stevehayles/HALMET-hardware/assembly/HALMET-In1_Cu.dxf

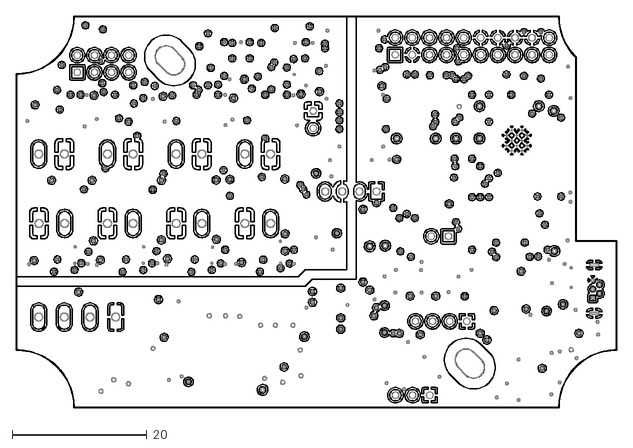
[picture p1: CAD file, 2025-12-01]
assembly/HALMET-In1_Cu.dxf
89.1 x 58.0
