stevehayles/HALMET-hardware/assembly/HALMET-B_Cu.dxf

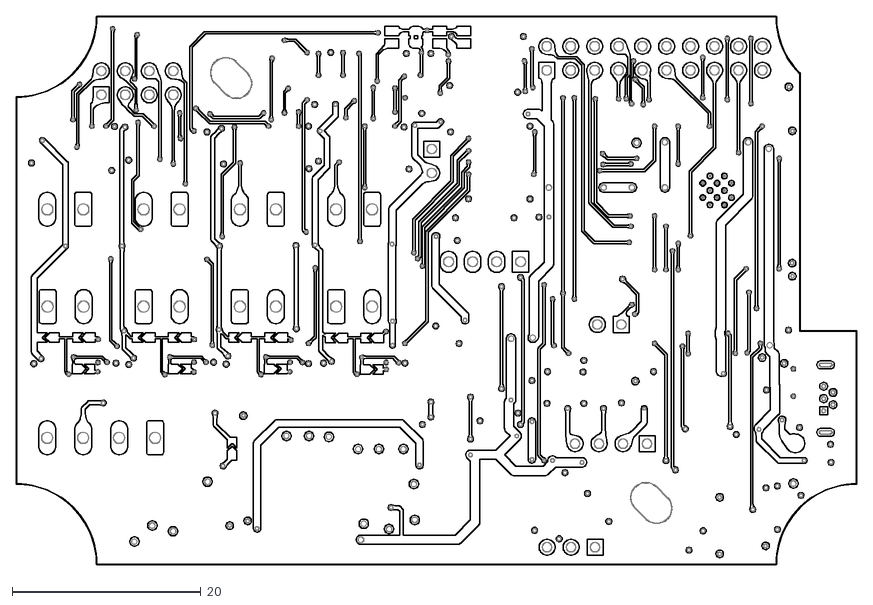
[picture p2: CAD file, 2025-12-01]
assembly/HALMET-B_Cu.dxf
89.1 x 58.0
