stevehayles/HALMET-hardware/assembly/HALMET-Edge_Cuts.dxf

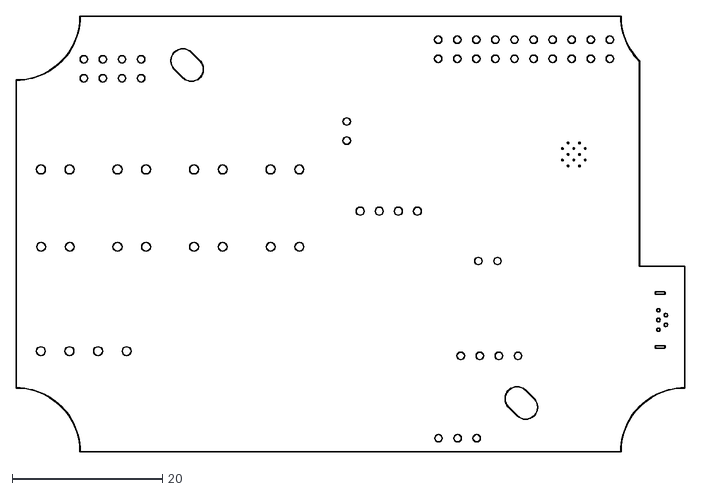
[picture p3: CAD file, 2025-12-01]
assembly/HALMET-Edge_Cuts.dxf
89.1 x 58.0
