stevehayles/HALMET-hardware/assembly/HALMET-F_Cu.dxf

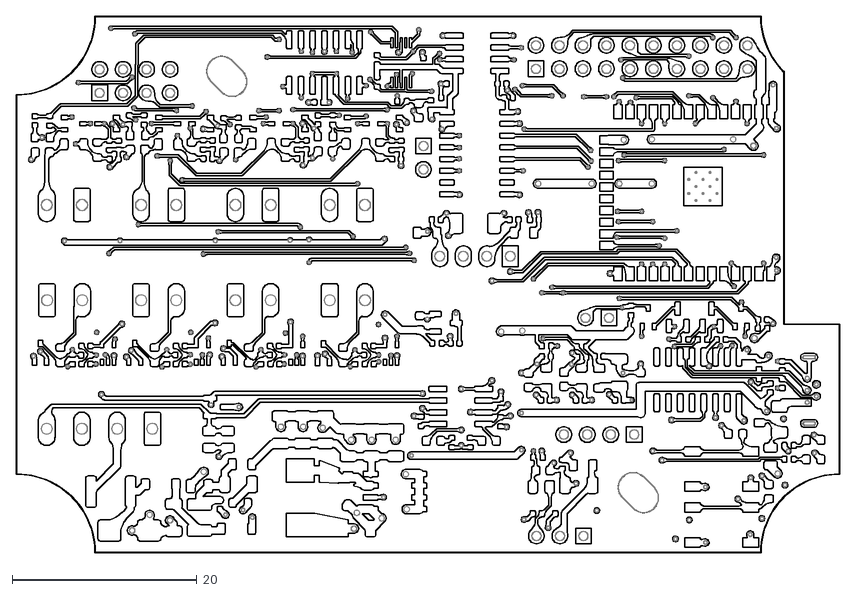
[picture p4: CAD file, 2025-12-01]
assembly/HALMET-F_Cu.dxf
89.1 x 58.0
