stevehayles/HALMET-hardware/(list of files, cad)

Other CAD files:
assembly/HALMET-B_Mask.dxf
assembly/HALMET-B_Silkscreen.dxf
assembly/HALMET-F_Mask.dxf
assembly/HALMET-F_Paste.dxf
assembly/HALMET-F_Silkscreen.dxf
