stevehayles/HALMET-hardware/HALMET.kicad_pcb

## KiCad design HALMET.kicad_pcb (2026-01-08)

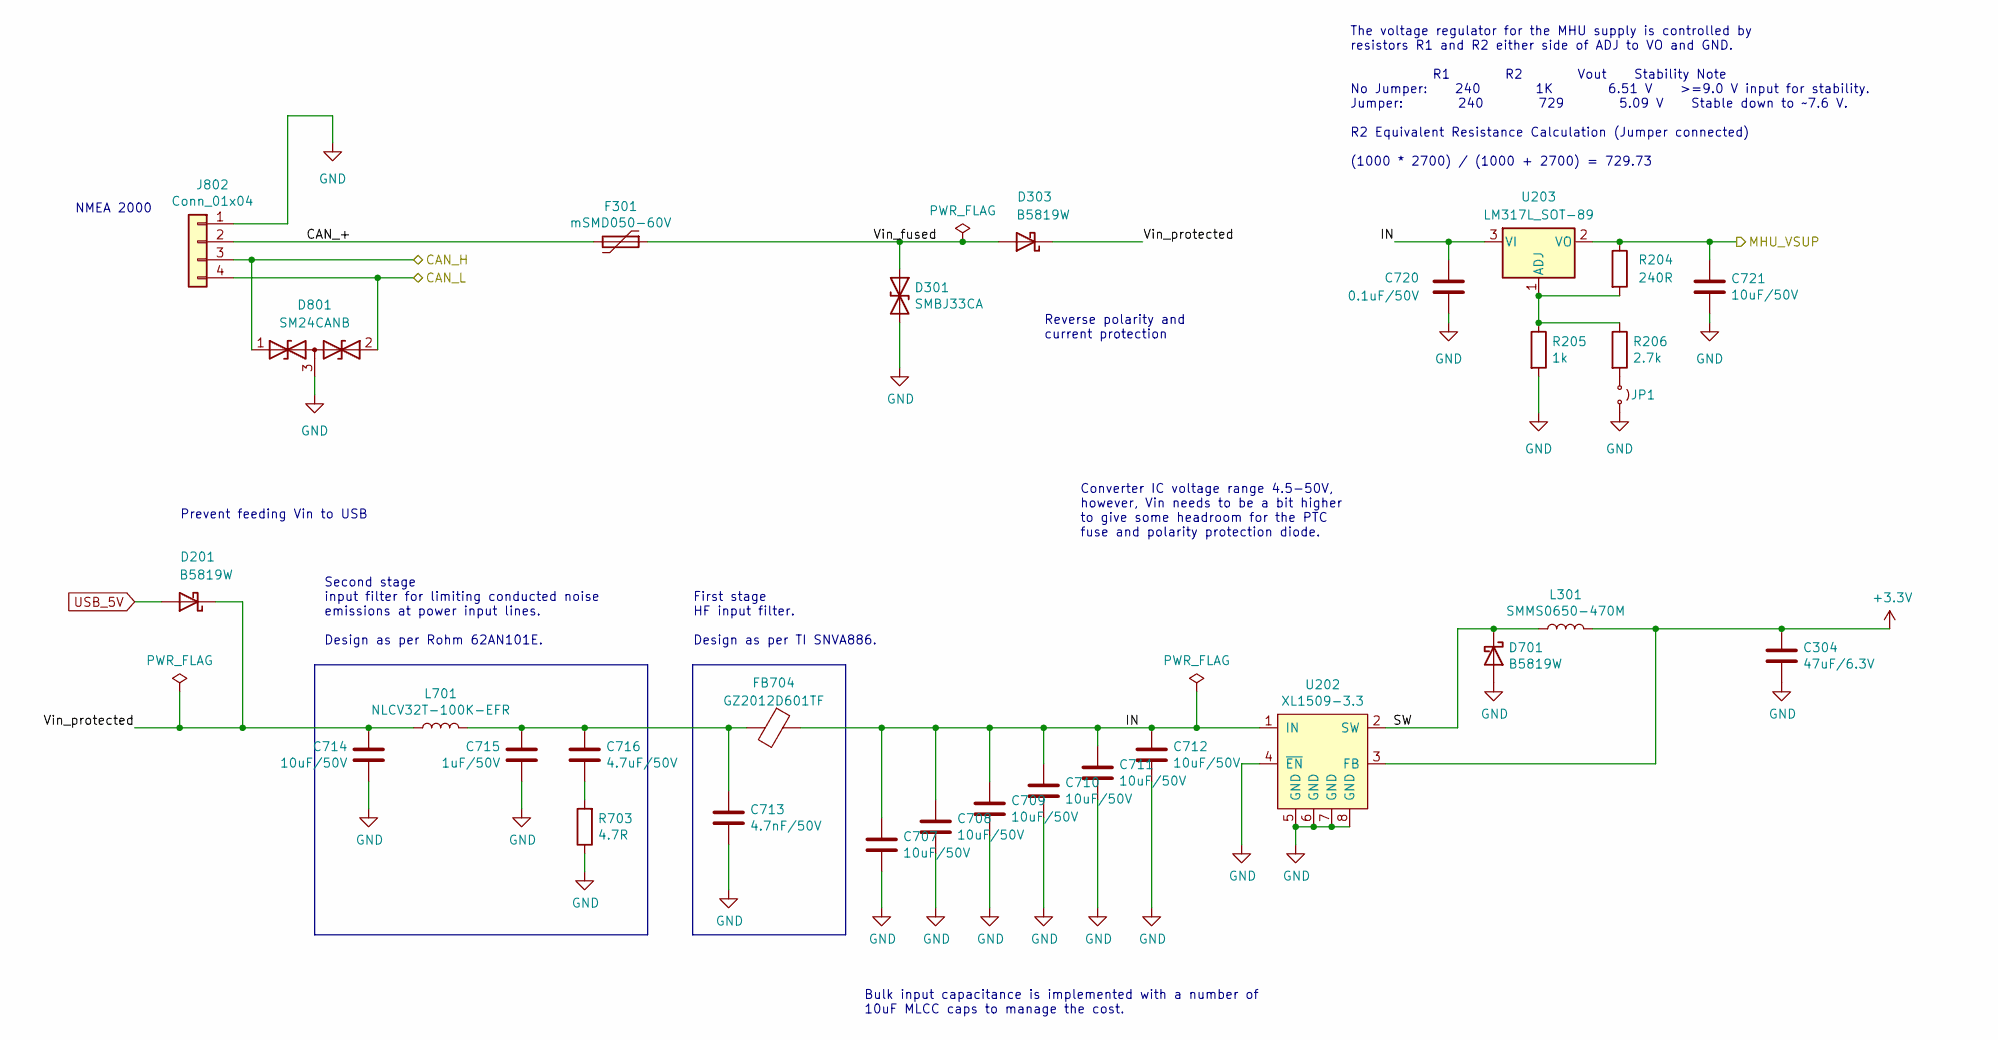
[picture p5: schematic power-input.kicad_sch, Bluefin Marine Processor]

Parts:
C304: 47uF/6.3V; C_1206_3216Metric; LCSC C96123
C707, C708, C709, C710, C711, C712, C714, C721: 10uF/50V; C_1206_3216Metric; LCSC C13585
C713: 4.7nF/50V; C_0402_1005Metric; LCSC C1538
C715: 1uF/50V; C_0805_2012Metric; LCSC C28323
C716: 4.7uF/50V; C_1206_3216Metric; LCSC C29823
C720: 0.1uF/50V; C_1206_3216Metric; LCSC C24497
D201, D303, D701: B5819W; D_SOD-123; LCSC C8598
D301: SMBJ33CA; D_SMB; LCSC C114000
D801: SM24CANB; SOT-23; LCSC C41376477
F301: mSMD050-60V; Fuse_1812_4532Metric; LCSC C70113
FB704: GZ2012D601TF; L_0805_2012Metric; LCSC C1017
J802: Conn_01x04; PhoenixContact_MCV_1,5_4-G-3.81_1x04_P3.81mm_Vertical; LCSC C8410
JP1: Jumper_2_Small_Open; PinHeader_1x02_P2.00mm_Vertical; LCSC C541856
L301: SMMS0650-470M; SMMS0650-1R0M; LCSC C149588
L701: NLCV32T-100K-EFR; L_1210_3225Metric; LCSC C295195
R204: 240R; R_0402_1005Metric; LCSC C25094
R205: 1k; R_0402_1005Metric; LCSC C11702
R206: 2.7k; R_0402_1005Metric; LCSC C25885
R703: 4.7R; R_0603_1608Metric; LCSC C23164
U202: XL1509-3.3; SOP-8_3.9x4.9mm_P1.27mm; LCSC C2681226
U203: LM317L_SOT-89; SOT-89-3; LCSC C5444280

Connections:
+3.3V: C304.1, L301.2, U202.3 (FB); also elsewhere on the board
/CAN_H: D801.1 (A1), J802.3; also elsewhere on the board
/CAN_L: D801.2 (A2), J802.4; also elsewhere on the board
/MHU_VSUP: C721.1, R204.1, U203.2 (VO); also elsewhere on the board
/Power input/CAN_+: F301.2, J802.2
/Power input/IN: C707.1, C708.1, C709.1, C710.1, C711.1, C712.1, C720.1, FB704.1, U202.1 (IN), U203.3 (VI)
/Power input/SW: D701.1 (K), L301.1, U202.2 (SW)
/Power input/Vin_fused: D301.1 (A1), D303.2 (A), F301.1
/Power input/Vin_protected: C714.2, D201.1 (K), D303.1 (K), L701.1
GND: C304.2, C707.2, C708.2, C709.2, C710.2, C711.2, C712.2, C713.2, C714.1, C715.1, C720.2, C721.2, D301.2 (A2), D701.2 (A), D801.3 (common), J802.1, JP1.2 (B), R205.2, R703.1, U202.4 (~EN), U202.5 (GND), U202.6 (GND), U202.7 (GND), U202.8 (GND); also elsewhere on the board
unnamed: C713.1, C715.2, C716.1, FB704.2, L701.2
unnamed: C716.2, R703.2
unnamed: JP1.1 (A), R206.2
unnamed: R204.2, R205.1, R206.1, U203.1 (ADJ)
USB_5V: D201.2 (A); also elsewhere on the board

Notes on the sheet:
Converter IC voltage range 4.5-50V, however, Vin needs to be a bit higher to give some headroom for the PTC fuse and polarity protection diode.
NMEA 2000
Bulk input capacitance is implemented with a number of 10uF MLCC caps to manage the cost.
Second stage input filter for limiting conducted noise emissions at power input lines. Design as per Rohm 62AN101E.
First stage HF input filter. Design as per TI SNVA886.
The voltage regulator for the MHU supply is controlled by resistors R1 and R2 either side of ADJ to VO and GND. R1 R2 Vout Stability Note No Jumper: 240 1K 6.51 V >=9.0 V input for stability. Jumper: 240 729 5.09 V Stable down to ~7.6 V. R2 Equivalent Resistance Calculation (Jumper connected) (1000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
Prevent feeding Vin to USB
Reverse polarity and current protection

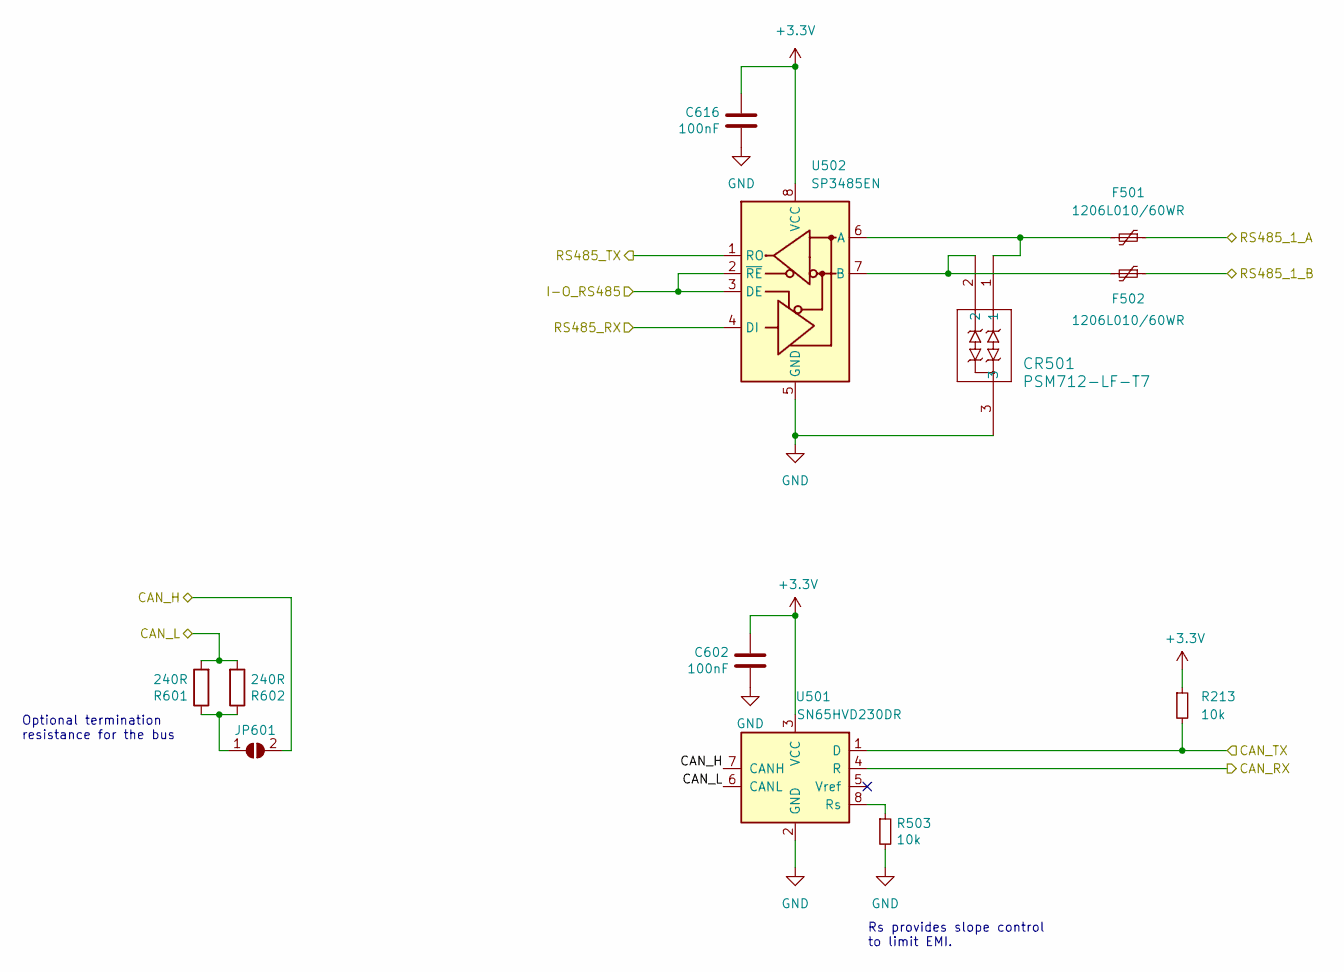
[picture p6: schematic serial.kicad_sch, Bluefin Marine Processor]

Parts:
C602, C616: 100nF; C_0402_1005Metric; LCSC C1525
CR501: PSM712-LF-T7; CR_SOT-23_PTD; LCSC C32677
F501, F502: 1206L010/60WR; 1206L075132WR; LCSC C2153714
JP601: SolderJumper_2_Open; SolderJumper-2_P1.3mm_Open_TrianglePad_Narrow
R213, R503: 10k; R_0402_1005Metric; LCSC C25744
R601, R602: 240R; R_0805_2012Metric; LCSC C17572
U501: SN65HVD230DR; SOIC-8_3.9x4.9mm_P1.27mm; LCSC C12084
U502: SP3485EN; SOIC-8_3.9x4.9mm_P1.27mm; LCSC C8963

Connections:
+3.3V: C602.1, C616.1, R213.1, U501.3 (VCC), U502.8 (VCC); also elsewhere on the board
/CAN_H: JP601.2 (B), U501.7 (CANH); also elsewhere on the board
/CAN_L: R601.2, R602.2, U501.6 (CANL); also elsewhere on the board
/CAN_RX: U501.4 (R); also elsewhere on the board
/CAN_TX: R213.2, U501.1 (D); also elsewhere on the board
/I-O_RS485: U502.2 (~RE), U502.3 (DE); also elsewhere on the board
/RS485_1_A: F501.1; also elsewhere on the board
/RS485_1_B: F502.1; also elsewhere on the board
/UART1_RX: U502.1 (RO); also elsewhere on the board
/UART1_TX: U502.4 (DI); also elsewhere on the board
GND: C602.2, C616.2, CR501.3, R503.2, U501.2 (GND), U502.5 (GND); also elsewhere on the board
unnamed: JP601.1 (A), R601.1, R602.1
unnamed: R503.1, U501.8 (Rs)
unnamed: CR501.1, F501.2, U502.6 (A)
unnamed: CR501.2, F502.2, U502.7 (B)

Notes on the sheet:
Rs provides slope control to limit EMI.
Optional termination resistance for the bus

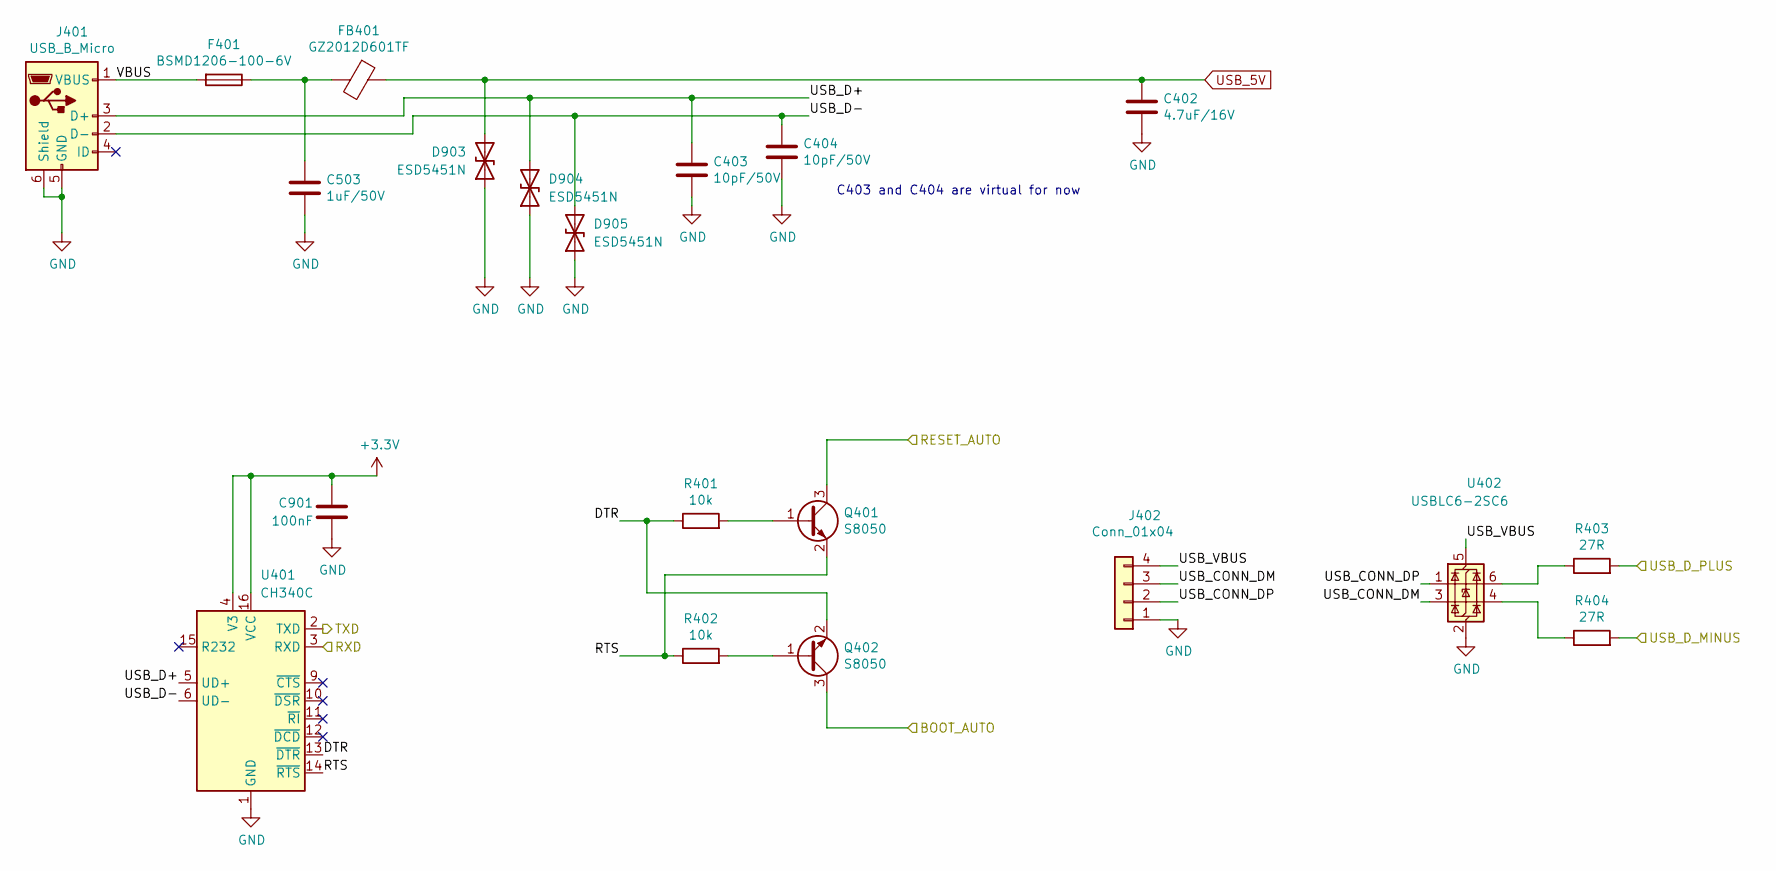
[picture p7: schematic USB.kicad_sch, Bluefin Marine Processor]

Parts:
C402: 4.7uF/16V; C_0603_1608Metric; LCSC C19666
C403, C404: 10pF/50V; C_0402_1005Metric; LCSC C32949
C503: 1uF/50V; C_0805_2012Metric; LCSC C28323
C901: 100nF; C_0402_1005Metric; LCSC C1525
D903, D904, D905: ESD5451N; D_0402_1005Metric; LCSC C2936977
F401: BSMD1206-100-6V; Fuse_1206_3216Metric; LCSC C883129
FB401: GZ2012D601TF; L_0805_2012Metric; LCSC C1017
J401: USB_B_Micro; USB_Micro-B_Wuerth_614105150721_Vertical; LCSC C145795
J402: Conn_01x04; JST_SH_BM04B-SRSS-TB_1x04-1MP_P1.00mm_Vertical; LCSC C160390
Q401, Q402: S8050; SOT-23; LCSC C2146
R401, R402: 10k; R_0402_1005Metric; LCSC C25744
R403, R404: 27R; R_0201_0603Metric; LCSC C270320
U401: CH340C; SOIC-16_3.9x9.9mm_P1.27mm; LCSC C84681
U402: USBLC6-2SC6; SOT-23-6; LCSC C7519

Connections:
+3.3V: C901.1, U401.4 (V3), U401.16 (VCC); also elsewhere on the board
/BOOT_AUTO: Q402.3 (C); also elsewhere on the board
/RESET_AUTO: Q401.3 (C); also elsewhere on the board
/UART0_RX: U401.2 (TXD); also elsewhere on the board
/UART0_TX: U401.3 (RXD); also elsewhere on the board
/USB/DTR: Q402.2 (E), R401.1, U401.13 (~DTR)
/USB/RTS: Q401.2 (E), R402.1, U401.14 (~RTS)
/USB/USB_CONN_DM: J402.3, U402.3 (I/O2)
/USB/USB_CONN_DP: J402.2, U402.1 (I/O1)
/USB/USB_D+: C403.1, D904.2 (A2), J401.3 (D+), U401.5 (UD+)
/USB/USB_D-: C404.1, D905.2 (A2), J401.2 (D-), U401.6 (UD-)
/USB/USB_VBUS: J402.4, U402.5 (VBUS)
/USB/VBUS: F401.2, J401.1 (VBUS)
/USB_D_MINUS: R404.2; also elsewhere on the board
/USB_D_PLUS: R403.2; also elsewhere on the board
GND: C402.2, C403.2, C404.2, C503.2, C901.2, D903.1 (A1), D904.1 (A1), D905.1 (A1), J401.5 (GND), J401.6 (Shield), J402.1, U401.1 (GND), U402.2 (GND); also elsewhere on the board
unnamed: C503.1, F401.1, FB401.2
unnamed: Q401.1 (B), R401.2
unnamed: Q402.1 (B), R402.2
unnamed: R403.1, U402.6 (I/O1)
unnamed: R404.1, U402.4 (I/O2)
USB_5V: C402.1, D903.2 (A2), FB401.1; also elsewhere on the board

Notes on the sheet:
C403 and C404 are virtual for now

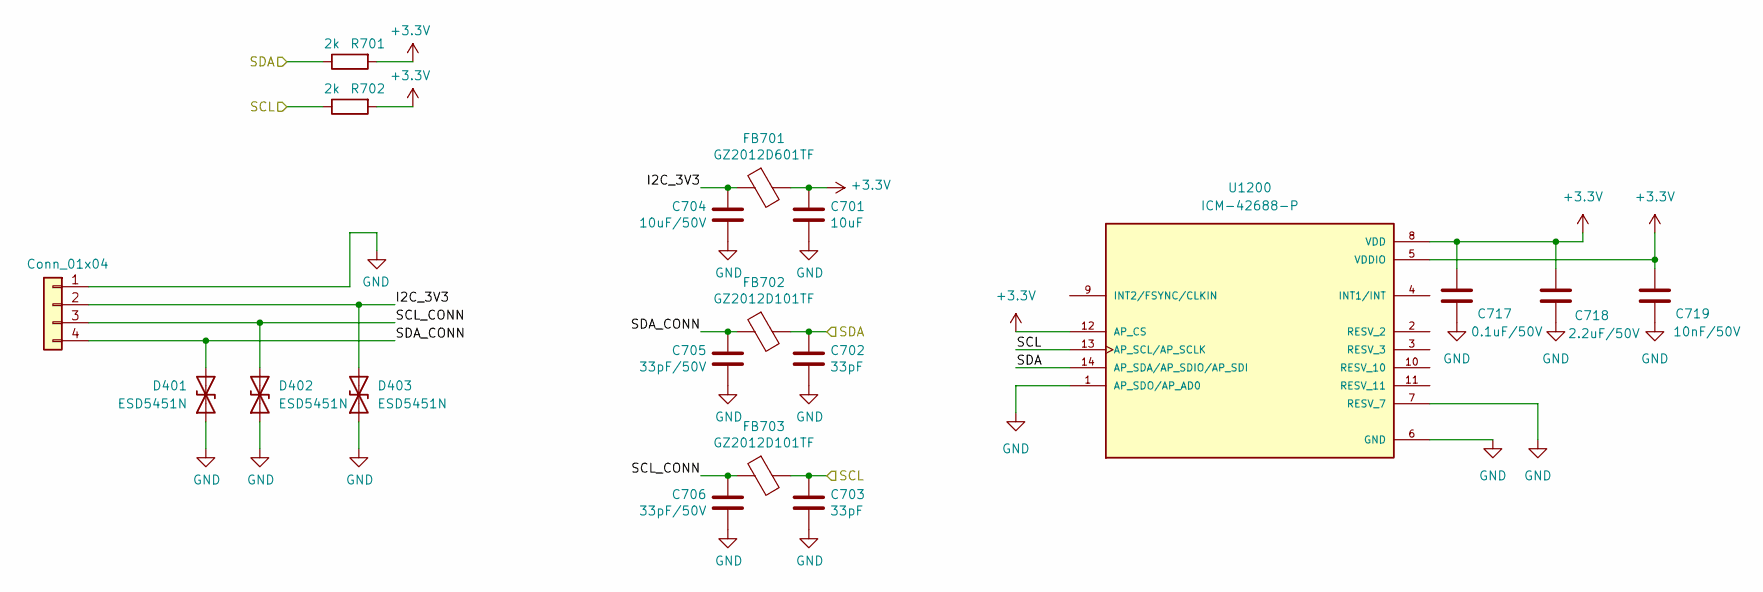
[picture p8: schematic I2C.kicad_sch, Bluefin Marine Processor]

Parts:
C701: 10uF; C_0402_1005Metric; LCSC C15525
C702, C703: 33pF; C_0402_1005Metric; LCSC C1562
C704: 10uF/50V; C_1206_3216Metric; LCSC C13585
C705, C706: 33pF/50V; C_0603_1608Metric; LCSC C1663
C717: 0.1uF/50V; C_1206_3216Metric; LCSC C24497
C718: 2.2uF/50V; C_1206_3216Metric; LCSC C50254
C719: 10nF/50V; C_1206_3216Metric; LCSC C153292
D401, D402, D403: ESD5451N; D_0402_1005Metric; LCSC C2936977
FB701: GZ2012D601TF; L_0805_2012Metric; LCSC C1017
FB702, FB703: GZ2012D101TF; L_0805_2012Metric; LCSC C1015
J702: Conn_01x04; PinSocket_1x04_P2.54mm_Vertical; LCSC C124413
R701, R702: 2k; R_0402_1005Metric; LCSC C4109
U1200: ICM-42688-P; PQFN50P300X250X97-14N; PARTREV 1.2; LCSC C1850418

Connections:
+3.3V: C701.1, C717.1, C718.1, C719.1, FB701.2, R701.2, R702.2, U1200.5 (VDDIO), U1200.8 (VDD), U1200.12 (AP_CS); also elsewhere on the board
/I2C/I2C_3V3: C704.1, D403.2 (A2), FB701.1, J702.2
/I2C/SCL_CONN: C706.1, D402.2 (A2), FB703.1, J702.3
/I2C/SDA_CONN: C705.1, D401.2 (A2), FB702.1, J702.4
/SCL: C703.1, FB703.2, R702.1, U1200.13 (AP_SCL/AP_SCLK); also elsewhere on the board
/SDA: C702.1, FB702.2, R701.1, U1200.14 (AP_SDA/AP_SDIO/AP_SDI); also elsewhere on the board
GND: C701.2, C702.2, C703.2, C704.2, C705.2, C706.2, C717.2, C718.2, C719.2, D401.1 (A1), D402.1 (A1), D403.1 (A1), J702.1, U1200.1 (AP_SDO/AP_AD0), U1200.6 (GND), U1200.7 (RESV_7); also elsewhere on the board

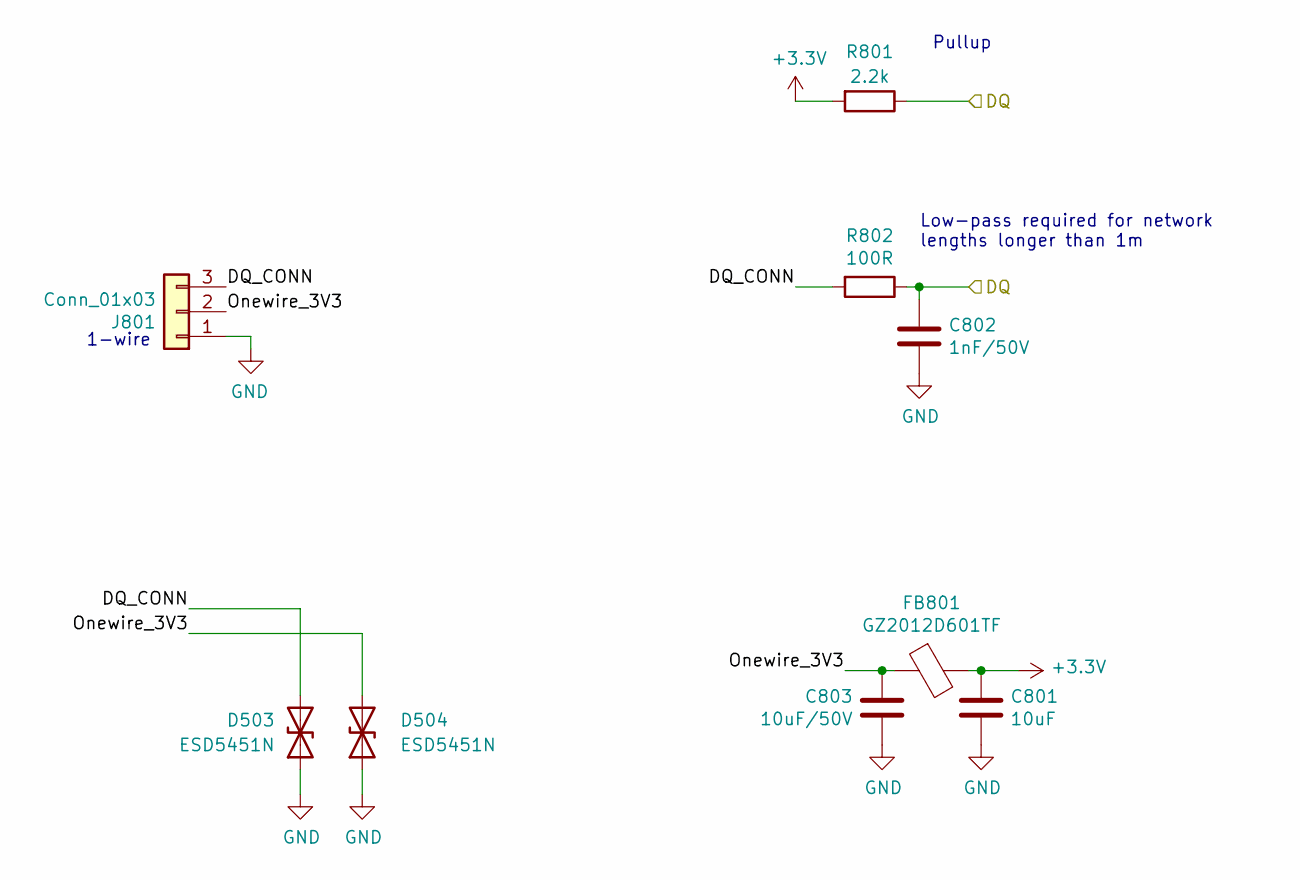
[picture p9: schematic onewire.kicad_sch, Bluefin Marine Processor]

Parts:
C801: 10uF; C_0402_1005Metric; LCSC C15525
C802: 1nF/50V; C_0603_1608Metric; LCSC C1588
C803: 10uF/50V; C_1206_3216Metric; LCSC C13585
D503, D504: ESD5451N; D_0402_1005Metric; LCSC C2936977
FB801: GZ2012D601TF; L_0805_2012Metric; LCSC C1017
J801: Conn_01x03; PinHeader_1x03_P2.54mm_Vertical; LCSC C49257
R801: 2.2k; R_0402_1005Metric; LCSC C25879
R802: 100R; R_0805_2012Metric; LCSC C17408

Connections:
+3.3V: C801.1, FB801.2, R801.2; also elsewhere on the board
/DQ: C802.1, R801.1, R802.1; also elsewhere on the board
/Onewire/DQ_CONN: D503.2 (A2), J801.3, R802.2
/Onewire/Onewire_3V3: C803.1, D504.2 (A2), FB801.1, J801.2
GND: C801.2, C802.2, C803.2, D503.1 (A1), D504.1 (A1), J801.1; also elsewhere on the board

Notes on the sheet:
1-wire
Low-pass required for network lengths longer than 1m
Pullup

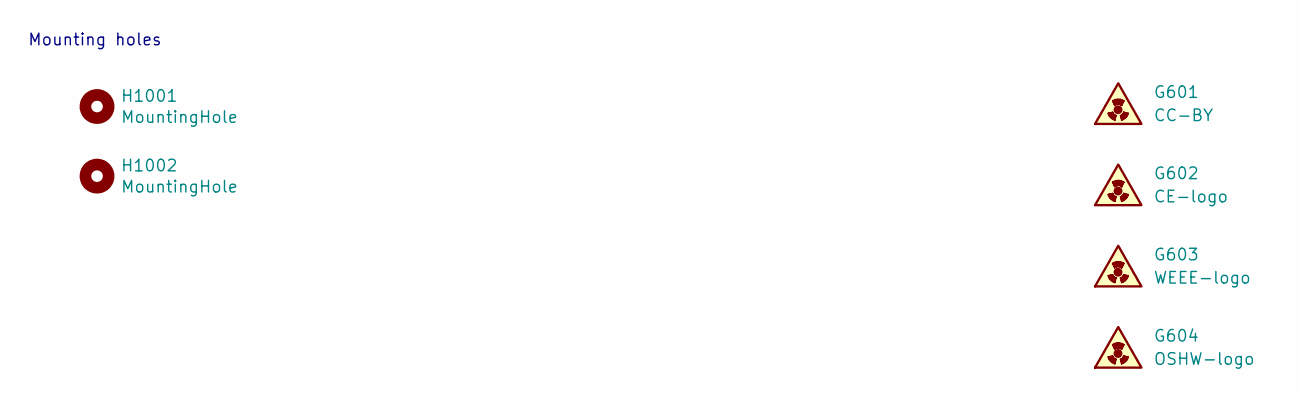
[picture p10: schematic PCB.kicad_sch, Bluefin Marine Processor]

Parts:
G601: CC-BY; cc-by_5mm
G602: CE-logo; CE-Logo_11.2x8mm_SilkScreen
G603: WEEE-logo; WEEE-Logo_5.6x8mm_SilkScreen
G604: OSHW-logo; OSHW-Logo2_9.8x8mm_SilkScreen
H1001, H1002: MountingHole; MountingSlot_3.2mm_M3_Unplated

Notes on the sheet:
Mounting holes

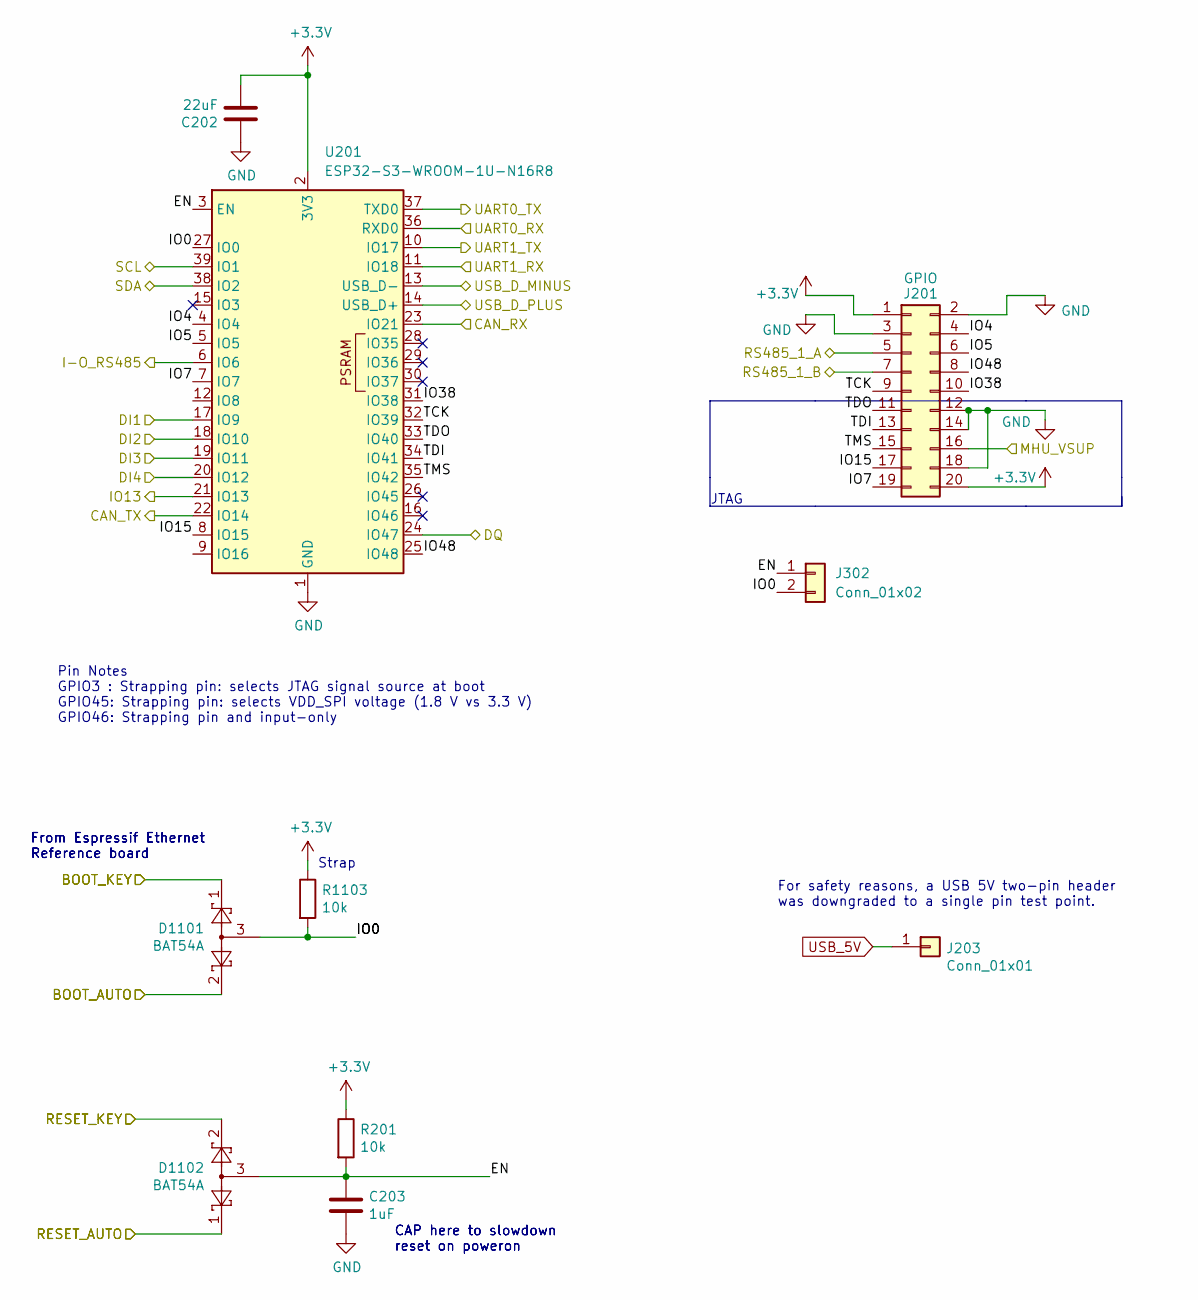
[picture p11: schematic ESP32.kicad_sch, Bluefin Marine Processor]

Parts:
C202: 22uF; C_0603_1608Metric; LCSC C59461
C203: 1uF; C_0402_1005Metric; LCSC C52923
D1101, D1102: BAT54A; SOT-323_SC-70; LCSC C78261
J201: GPIO; PinHeader_2x10_P2.54mm_Vertical; LCSC C492427
J203: Conn_01x01; TestPoint_Pad_D2.0mm
J302: Conn_01x02; PinHeader_1x02_P2.54mm_Vertical
R201, R1103: 10k; R_0402_1005Metric; LCSC C25744
U201: ESP32-S3-WROOM-1U-N16R8; ESP32-S3-WROOM-1U; LCSC C3013946

Connections:
+3.3V: C202.2, J201.1, J201.20, R201.1, R1103.1, U201.2 (3V3); also elsewhere on the board
/BOOT_AUTO: D1101.2; also elsewhere on the board
/BOOT_KEY: D1101.1; also elsewhere on the board
/CAN_RX: U201.23 (IO21); also elsewhere on the board
/CAN_TX: U201.22 (IO14); also elsewhere on the board
/DI1: U201.17 (IO9); also elsewhere on the board
/DI2: U201.18 (IO10); also elsewhere on the board
/DI3: U201.19 (IO11); also elsewhere on the board
/DI4: U201.20 (IO12); also elsewhere on the board
/DQ: U201.24 (IO47); also elsewhere on the board
/ESP32/EN: C203.1, D1102.3, J302.1, R201.2, U201.3 (EN)
/ESP32/IO0: D1101.3, J302.2, R1103.2, U201.27 (IO0)
/ESP32/IO4: J201.4, U201.4 (IO4)
/ESP32/IO5: J201.6, U201.5 (IO5)
/ESP32/IO7: J201.19, U201.7 (IO7)
/ESP32/IO15: J201.17, U201.8 (IO15)
/ESP32/IO38: J201.10, U201.31 (IO38)
/ESP32/IO48: J201.8, U201.25 (IO48)
/ESP32/TCK: J201.9, U201.32 (IO39)
/ESP32/TDI: J201.13, U201.34 (IO41)
/ESP32/TDO: J201.11, U201.33 (IO40)
/ESP32/TMS: J201.15, U201.35 (IO42)
/I-O_RS485: U201.6 (IO6); also elsewhere on the board
/LED: U201.21 (IO13); also elsewhere on the board
/MHU_VSUP: J201.16; also elsewhere on the board
/RESET_AUTO: D1102.1; also elsewhere on the board
/RESET_KEY: D1102.2; also elsewhere on the board
/RS485_1_A: J201.5; also elsewhere on the board
/RS485_1_B: J201.7; also elsewhere on the board
/SCL: U201.39 (IO1); also elsewhere on the board
/SDA: U201.38 (IO2); also elsewhere on the board
/UART0_RX: U201.36 (RXD0); also elsewhere on the board
/UART0_TX: U201.37 (TXD0); also elsewhere on the board
/UART1_RX: U201.11 (IO18); also elsewhere on the board
/UART1_TX: U201.10 (IO17); also elsewhere on the board
/USB_D_MINUS: U201.13 (USB_D-); also elsewhere on the board
/USB_D_PLUS: U201.14 (USB_D+); also elsewhere on the board
GND: C202.1, C203.2, J201.2, J201.3, J201.12, J201.14, J201.18, U201.1 (GND), U201.40 (GND), U201.41 (GND); also elsewhere on the board
USB_5V: J203.1; also elsewhere on the board

Notes on the sheet:
CAP here to slowdown reset on poweron
JTAG
From Espressif Ethernet Reference board
Strap
Pin Notes GPIO3 : Strapping pin: selects JTAG signal source at boot GPIO45: Strapping pin: selects VDD_SPI voltage (1.8 V vs 3.3 V) GPIO46: Strapping pin and input-only
For safety reasons, a USB 5V two-pin header was downgraded to a single pin test point.

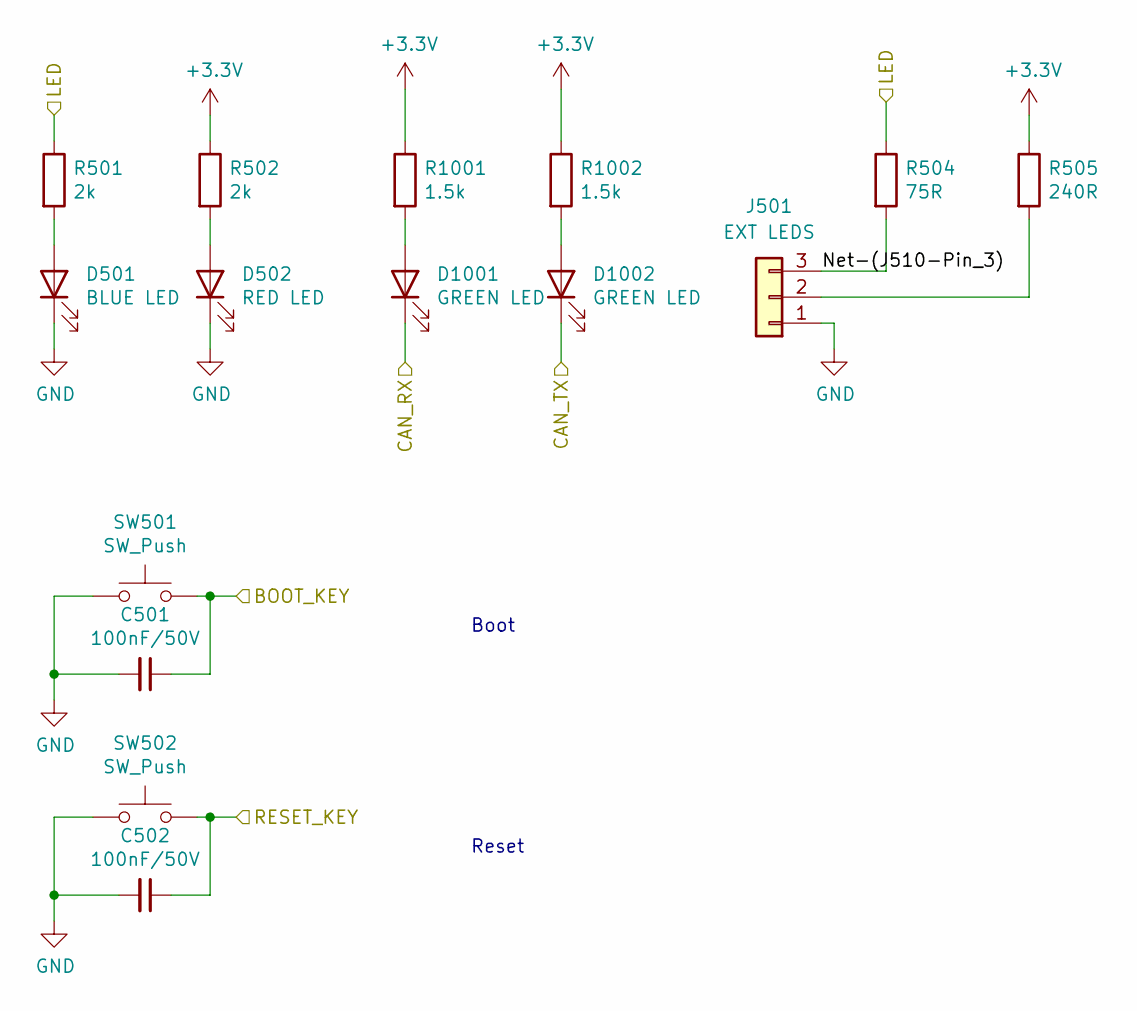
[picture p12: schematic UI.kicad_sch, Bluefin Marine Processor]

Parts:
C501, C502: 100nF/50V; C_0603_1608Metric; LCSC C14663
D501: BLUE LED; LED_0603_1608Metric; LCSC C84266
D502: RED LED; LED_0603_1608Metric; LCSC C2286
D1001, D1002: GREEN LED; LED_0603_1608Metric; LCSC C965804
J501: EXT LEDS; PinHeader_1x03_P2.00mm_Vertical; LCSC C541857
R501, R502: 2k; R_0402_1005Metric; LCSC C4109
R504: 75R; R_0402_1005Metric; LCSC C25133
R505: 240R; R_0402_1005Metric; LCSC C25094
R1001, R1002: 1.5k; R_0402_1005Metric; LCSC C25867
SW501, SW502: SW_Push; SW_SPST_TL3342; LCSC C318887

Connections:
+3.3V: R502.1, R505.1, R1001.1, R1002.1; also elsewhere on the board
/BOOT_KEY: C501.1, SW501.2; also elsewhere on the board
/CAN_RX: D1001.1 (K); also elsewhere on the board
/CAN_TX: D1002.1 (K); also elsewhere on the board
/LED: R501.1, R504.1; also elsewhere on the board
/RESET_KEY: C502.1, SW502.2; also elsewhere on the board
/User Interface/<NO NET>: J501.3, R504.2
GND: C501.2, C502.2, D501.1 (K), D502.1 (K), J501.1, SW501.1, SW502.1; also elsewhere on the board
unnamed: D501.2 (A), R501.2
unnamed: D502.2 (A), R502.2
unnamed: D1001.2 (A), R1001.2
unnamed: D1002.2 (A), R1002.2
unnamed: J501.2, R505.2

Notes on the sheet:
Reset
Boot

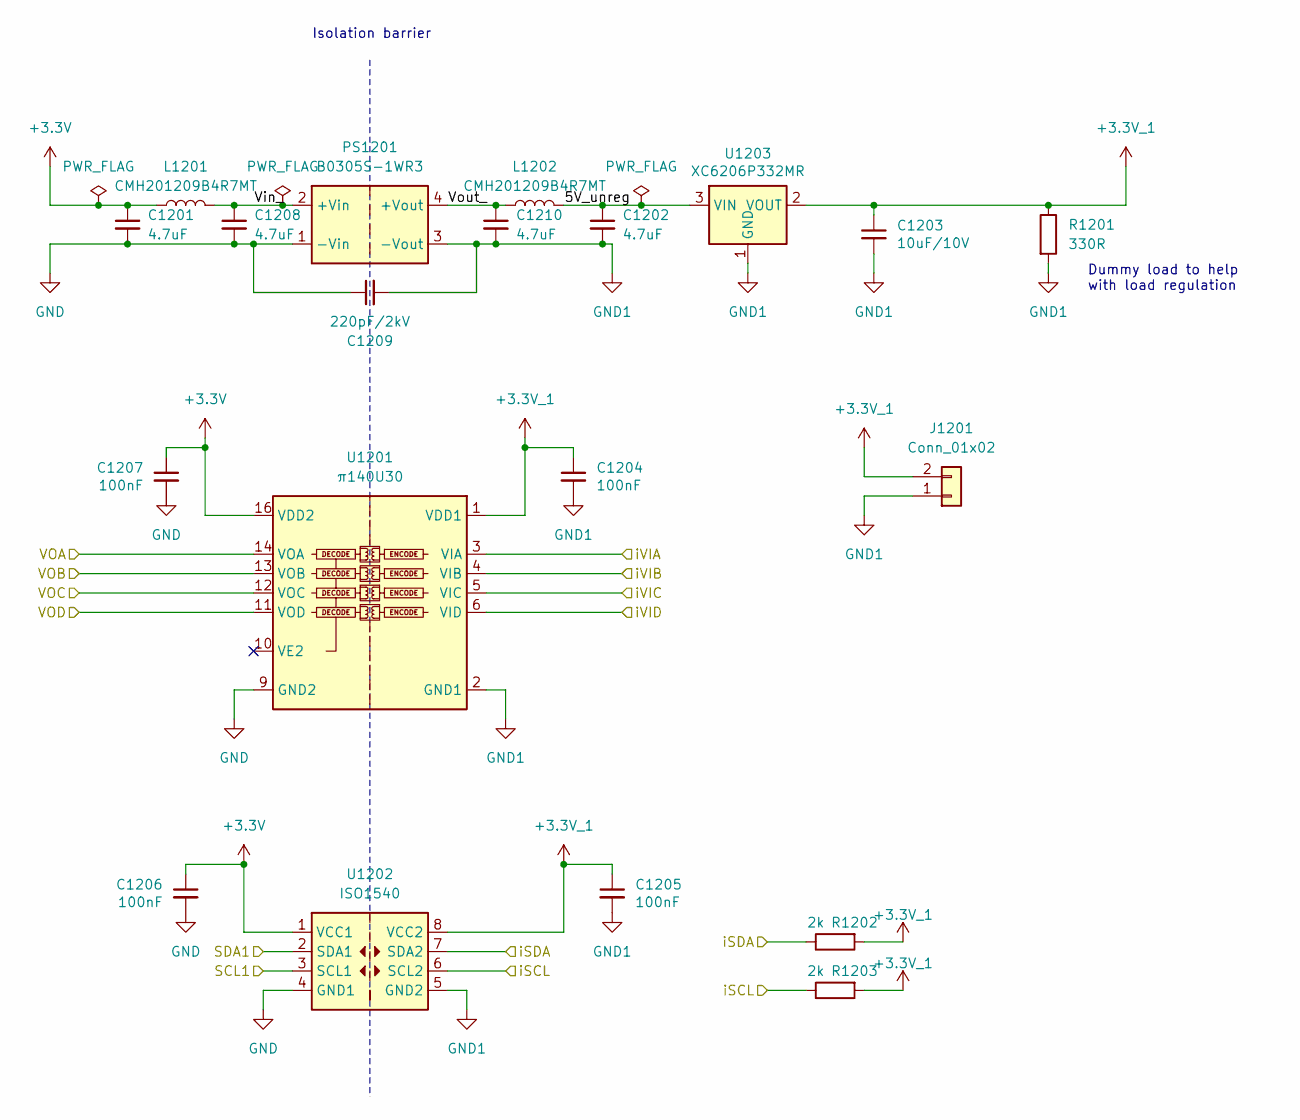
[picture p13: schematic isolation.kicad_sch, Bluefin Marine Processor]

Parts:
C1201, C1202, C1208, C1210: 4.7uF; C_0402_1005Metric; LCSC C23733
C1203: 10uF/10V; C_0603_1608Metric; LCSC C19702
C1204, C1205, C1206, C1207: 100nF; C_0402_1005Metric; LCSC C1525
C1209: 220pF/2kV; C_1808_4520Metric; LCSC C2940747
J1201: Conn_01x02; PinHeader_1x02_P2.54mm_Vertical
L1201, L1202: CMH201209B4R7MT; L_0805_2012Metric; LCSC C394959
PS1201: B0305S-1WR3; Converter_DCDC_Murata_MEE1SxxxxSC_THT; LCSC C7465186
R1201: 330R; R_0402_1005Metric; LCSC C25104
R1202, R1203: 2k; R_0402_1005Metric; LCSC C4109
U1201: π140U30; SOIC-16_4.55x10.3mm_P1.27mm; LCSC C910134
U1202: ISO1540; SOIC-8_3.9x4.9mm_P1.27mm; LCSC C179739
U1203: XC6206P332MR; SOT-23-3; LCSC C5446

Connections:
+3.3V: C1201.1, C1206.1, C1207.1, L1201.1, U1201.16 (VDD2), U1202.1 (VCC1); also elsewhere on the board
+3.3V_1: C1203.1, C1204.1, C1205.1, J1201.2, R1201.1, R1202.2, R1203.2, U1201.1 (VDD1), U1202.8 (VCC2), U1203.2 (VOUT); also elsewhere on the board
/Analog input/SCL: R1203.1, U1202.6 (SCL2); also elsewhere on the board
/Analog input/SDA: R1202.1, U1202.7 (SDA2); also elsewhere on the board
/DI1: U1201.14 (VOA); also elsewhere on the board
/DI2: U1201.13 (VOB); also elsewhere on the board
/DI3: U1201.12 (VOC); also elsewhere on the board
/DI4: U1201.11 (VOD); also elsewhere on the board
/Digital input/DigIn1: U1201.3 (VIA); also elsewhere on the board
/Digital input/DigIn2: U1201.4 (VIB); also elsewhere on the board
/Digital input/DigIn3: U1201.5 (VIC); also elsewhere on the board
/Digital input/DigIn4: U1201.6 (VID); also elsewhere on the board
/Isolation barrier/5V_unreg: C1202.1, L1202.2, U1203.3 (VIN)
/Isolation barrier/Vin_: C1208.1, L1201.2, PS1201.2 (+Vin)
/Isolation barrier/Vout_: C1210.1, L1202.1, PS1201.4 (+Vout)
/SCL: U1202.3 (SCL1); also elsewhere on the board
/SDA: U1202.2 (SDA1); also elsewhere on the board
GND: C1201.2, C1206.2, C1207.2, C1208.2, C1209.1, PS1201.1 (-Vin), U1201.9 (GND2), U1201.15 (GND2), U1202.4 (GND1); also elsewhere on the board
GND1: C1202.2, C1203.2, C1204.2, C1205.2, C1209.2, C1210.2, J1201.1, PS1201.3 (-Vout), R1201.2, U1201.2 (GND1), U1201.8 (GND1), U1202.5 (GND2), U1203.1 (GND); also elsewhere on the board

Notes on the sheet:
Dummy load to help with load regulation
Isolation barrier
