stevehayles/HALMET-hardware/HALMET.kicad_pcb

## KiCad design HALMET.kicad_pcb (continued)

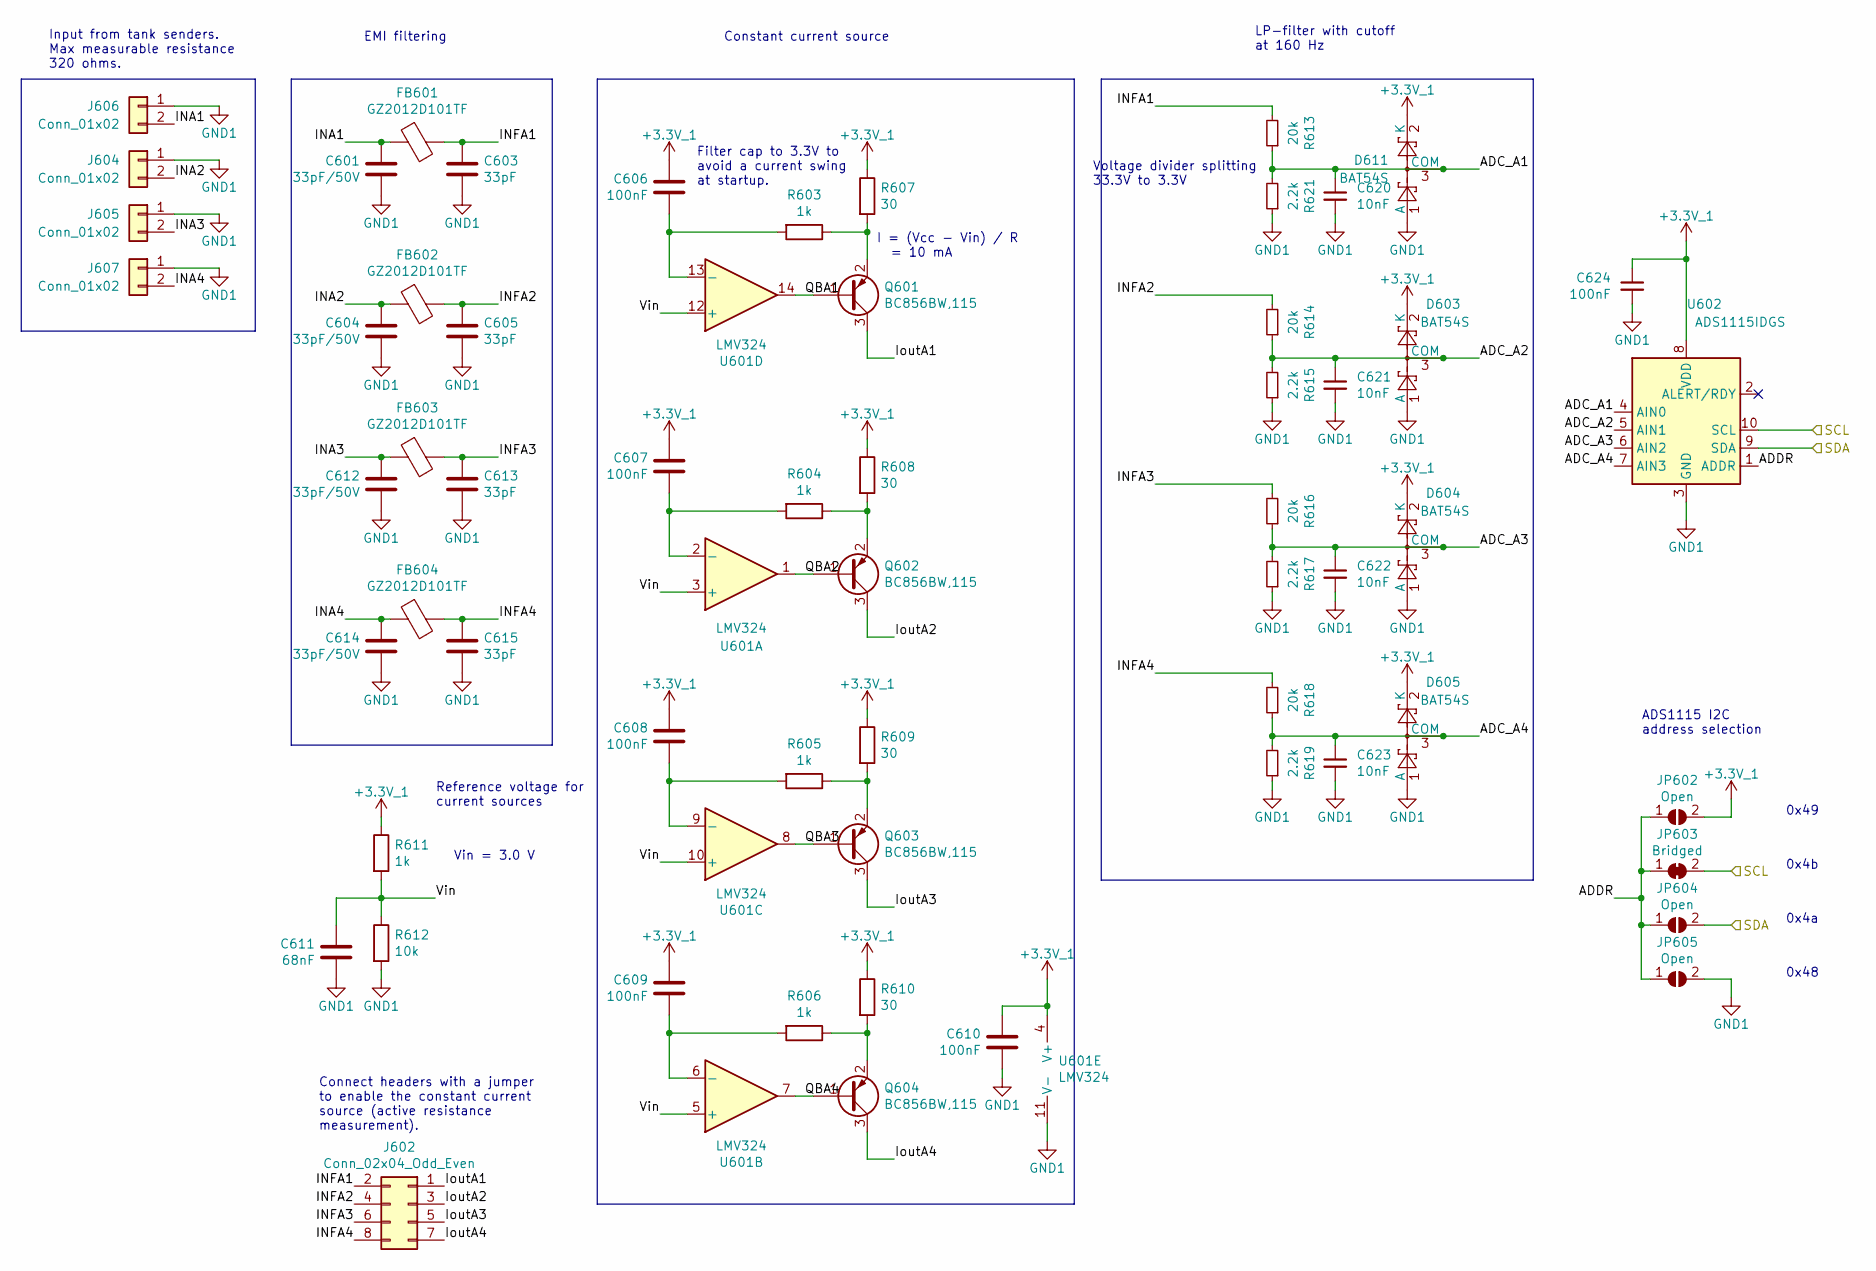
[picture p14: schematic analog_input.kicad_sch, Bluefin Marine Processor]

Parts:
C601, C604, C612, C614: 33pF/50V; C_0603_1608Metric; LCSC C1663
C603, C605, C613, C615: 33pF; C_0402_1005Metric; LCSC C1562
C606, C607, C608, C609, C610, C624: 100nF; C_0402_1005Metric; LCSC C1525
C611: 68nF; C_0603_1608Metric; LCSC C31658
C620, C621, C622, C623: 10nF; C_0402_1005Metric; LCSC C15195
D603, D604, D605, D611: BAT54S; SOT-323_SC-70; LCSC C12741
FB601, FB602, FB603, FB604: GZ2012D101TF; L_0805_2012Metric; LCSC C1015
J602: Conn_02x04_Odd_Even; PinHeader_2x04_P2.54mm_Vertical; LCSC C124386
J604, J605, J606, J607: Conn_01x02; PhoenixContact_MCV_1,5_2-G-3.81_1x02_P3.81mm_Vertical; LCSC C8396
JP602, JP604, JP605: Open; SolderJumper-2_P1.3mm_Open_Pad1.0x1.5mm
JP603: Bridged; SolderJumper-2_P1.3mm_Bridged2Bar_RoundedPad1.0x1.5mm
Q601, Q602, Q603, Q604: BC856BW,115; SOT-323_SC-70; LCSC C28063
R603, R604, R605, R606, R611: 1k; R_0402_1005Metric; LCSC C11702
R607, R608, R609, R610: 30; R_0603_1608Metric; LCSC C22985
R612: 10k; R_0402_1005Metric; LCSC C25744
R613, R614, R616, R618: 20k; R_0603_1608Metric; LCSC C4184
R615, R617, R619, R621: 2.2k; R_0402_1005Metric; LCSC C25879
U601: LMV324; SOIC-14_3.9x8.7mm_P1.27mm; LCSC C362275
U602: ADS1115IDGS; TSSOP-10_3x3mm_P0.5mm; LCSC C37593

Connections:
+3.3V_1: C606.2, C607.2, C608.2, C609.2, C610.1, C624.1, D603.2 (K), D604.2 (K), D605.2 (K), D611.2 (K), JP602.2 (B), R607.1, R608.1, R609.1, R610.1, R611.1, U601.4 (V+), U602.8 (VDD); also elsewhere on the board
/Analog input/ADC_A1: C620.1, D611.3 (COM), R613.1, R621.2, U602.4 (AIN0)
/Analog input/ADC_A2: C621.1, D603.3 (COM), R614.1, R615.2, U602.5 (AIN1)
/Analog input/ADC_A3: C622.1, D604.3 (COM), R616.1, R617.2, U602.6 (AIN2)
/Analog input/ADC_A4: C623.1, D605.3 (COM), R618.1, R619.2, U602.7 (AIN3)
/Analog input/ADDR: JP602.1 (A), JP603.1 (A), JP604.1 (A), JP605.1 (A), U602.1 (ADDR)
/Analog input/INA1: C601.1, FB601.1, J606.2
/Analog input/INA2: C604.1, FB602.1, J604.2
/Analog input/INA3: C612.1, FB603.1, J605.2
/Analog input/INA4: C614.1, FB604.1, J607.2
/Analog input/INFA1: C603.1, FB601.2, J602.2, R613.2
/Analog input/INFA2: C605.1, FB602.2, J602.4, R614.2
/Analog input/INFA3: C613.1, FB603.2, J602.6, R616.2
/Analog input/INFA4: C615.1, FB604.2, J602.8, R618.2
/Analog input/IoutA1: J602.1, Q601.3 (C)
/Analog input/IoutA2: J602.3, Q602.3 (C)
/Analog input/IoutA3: J602.5, Q603.3 (C)
/Analog input/IoutA4: J602.7, Q604.3 (C)
/Analog input/QBA1: Q601.1 (B), U601.14
/Analog input/QBA2: Q602.1 (B), U601.1
/Analog input/QBA3: Q603.1 (B), U601.8
/Analog input/QBA4: Q604.1 (B), U601.7
/Analog input/SCL: JP603.2 (B), U602.10 (SCL); also elsewhere on the board
/Analog input/SDA: JP604.2 (B), U602.9 (SDA); also elsewhere on the board
/Analog input/Vin: C611.1, R611.2, R612.1, U601.3 (+), U601.5 (+), U601.10 (+), U601.12 (+)
GND1: C601.2, C603.2, C604.2, C605.2, C610.2, C611.2, C612.2, C613.2, C614.2, C615.2, C620.2, C621.2, C622.2, C623.2, C624.2, D603.1 (A), D604.1 (A), D605.1 (A), D611.1 (A), J604.1, J605.1, J606.1, J607.1, JP605.2 (B), R612.2, R615.1, R617.1, R619.1, R621.1, U601.11 (V-), U602.3 (GND); also elsewhere on the board
unnamed: Q601.2 (E), R603.1, R607.2
unnamed: Q602.2 (E), R604.1, R608.2
unnamed: Q603.2 (E), R605.1, R609.2
unnamed: Q604.2 (E), R606.1, R610.2
unnamed: C607.1, R604.2, U601.2 (-)
unnamed: C609.1, R606.2, U601.6 (-)
unnamed: C608.1, R605.2, U601.9 (-)
unnamed: C606.1, R603.2, U601.13 (-)

Notes on the sheet:
Vin = 3.0 V
ADS1115 I2C address selection
0x49
EMI filtering
I = (Vcc - Vin) / R = 10 mA
Constant current source
Voltage divider splitting 33.3V to 3.3V
0x48
Input from tank senders. Max measurable resistance 320 ohms.
0x4a
Reference voltage for current sources
0x4b
LP-filter with cutoff at 160 Hz
Connect headers with a jumper to enable the constant current source (active resistance measurement).
Filter cap to 3.3V to avoid a current swing at startup.

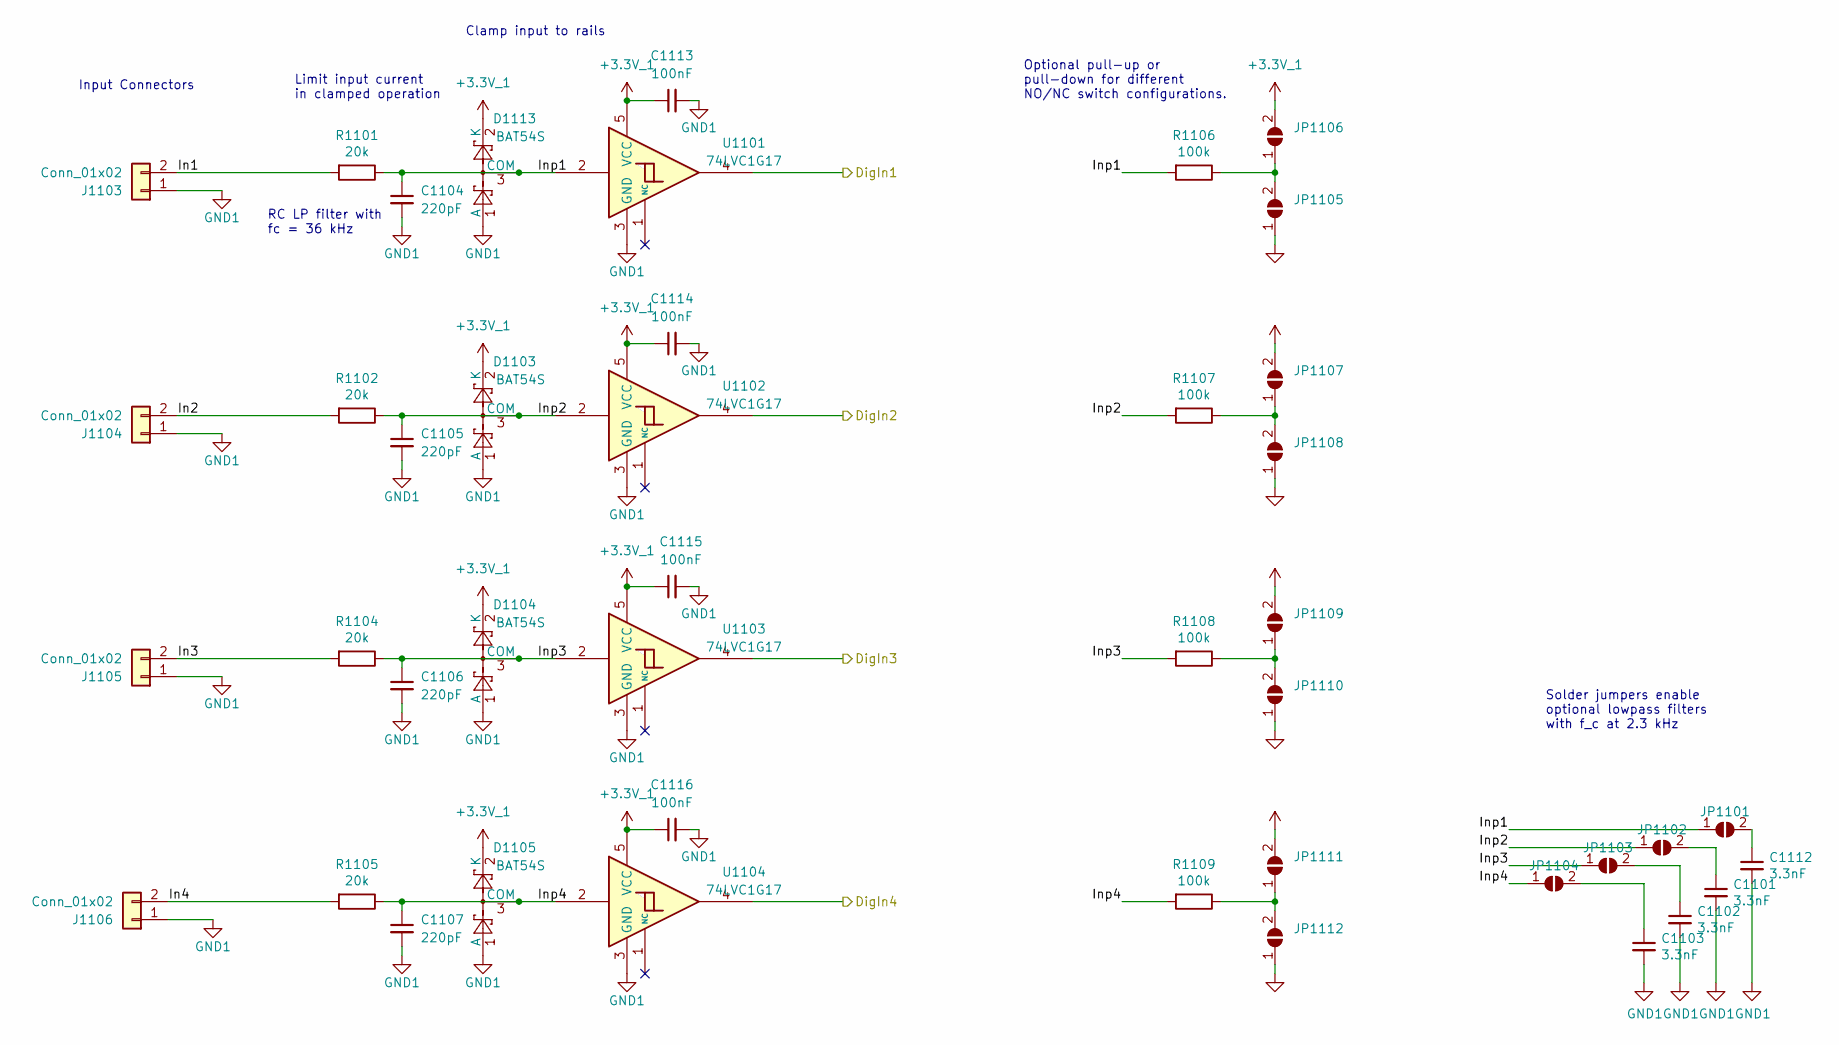
[picture p15: schematic digital_input.kicad_sch, Bluefin Marine Processor]

Parts:
C1101, C1102, C1103, C1112: 3.3nF; C_0402_1005Metric; LCSC C26404
C1104, C1105, C1106, C1107: 220pF; R_0402_1005Metric; LCSC C1530
C1113, C1114, C1115, C1116: 100nF; C_0402_1005Metric; LCSC C1525
D1103, D1104, D1105, D1113: BAT54S; SOT-323_SC-70; LCSC C12741
J1103, J1104, J1105, J1106: Conn_01x02; PhoenixContact_MCV_1,5_2-G-3.81_1x02_P3.81mm_Vertical; LCSC C8396
JP1101, JP1102, JP1103, JP1104, JP1105, JP1106, JP1107, JP1108, JP1109, JP1110, JP1111, JP1112: SolderJumper_2_Open; SolderJumper-2_P1.3mm_Open_TrianglePad_Narrow
R1101, R1102, R1104, R1105: 20k; R_0603_1608Metric; LCSC C4184
R1106, R1107, R1108, R1109: 100k; R_0402_1005Metric; LCSC C25741
U1101, U1102, U1103, U1104: 74LVC1G17; SOT-353_SC-70-5; LCSC C212314

Connections:
+3.3V_1: C1113.1, C1114.1, C1115.1, C1116.1, D1103.2 (K), D1104.2 (K), D1105.2 (K), D1113.2 (K), JP1106.2 (B), JP1107.2 (B), JP1109.2 (B), JP1111.2 (B), U1101.5 (VCC), U1102.5 (VCC), U1103.5 (VCC), U1104.5 (VCC); also elsewhere on the board
/Digital input/DigIn1: U1101.4; also elsewhere on the board
/Digital input/DigIn2: U1102.4; also elsewhere on the board
/Digital input/DigIn3: U1103.4; also elsewhere on the board
/Digital input/DigIn4: U1104.4; also elsewhere on the board
/Digital input/In1: J1103.2, R1101.2
/Digital input/In2: J1104.2, R1102.2
/Digital input/In3: J1105.2, R1104.2
/Digital input/In4: J1106.2, R1105.2
/Digital input/Inp1: C1104.1, D1113.3 (COM), JP1101.1 (A), R1101.1, R1106.2, U1101.2
/Digital input/Inp2: C1105.1, D1103.3 (COM), JP1102.1 (A), R1102.1, R1107.2, U1102.2
/Digital input/Inp3: C1106.1, D1104.3 (COM), JP1103.1 (A), R1104.1, R1108.2, U1103.2
/Digital input/Inp4: C1107.1, D1105.3 (COM), JP1104.1 (A), R1105.1, R1109.2, U1104.2
GND1: C1101.2, C1102.2, C1103.2, C1104.2, C1105.2, C1106.2, C1107.2, C1112.2, C1113.2, C1114.2, C1115.2, C1116.2, D1103.1 (A), D1104.1 (A), D1105.1 (A), D1113.1 (A), J1103.1, J1104.1, J1105.1, J1106.1, JP1105.1 (A), JP1108.1 (A), JP1110.1 (A), JP1112.1 (A), U1101.3 (GND), U1102.3 (GND), U1103.3 (GND), U1104.3 (GND); also elsewhere on the board
unnamed: C1112.1, JP1101.2 (B)
unnamed: C1101.1, JP1102.2 (B)
unnamed: C1102.1, JP1103.2 (B)
unnamed: C1103.1, JP1104.2 (B)
unnamed: JP1105.2 (B), JP1106.1 (A), R1106.1
unnamed: JP1107.1 (A), JP1108.2 (B), R1107.1
unnamed: JP1109.1 (A), JP1110.2 (B), R1108.1
unnamed: JP1111.1 (A), JP1112.2 (B), R1109.1

Notes on the sheet:
RC LP filter with fc = 36 kHz
Clamp input to rails
Input Connectors
Optional pull-up or pull-down for different NO/NC switch configurations.
Solder jumpers enable optional lowpass filters with f_c at 2.3 kHz
Limit input current in clamped operation

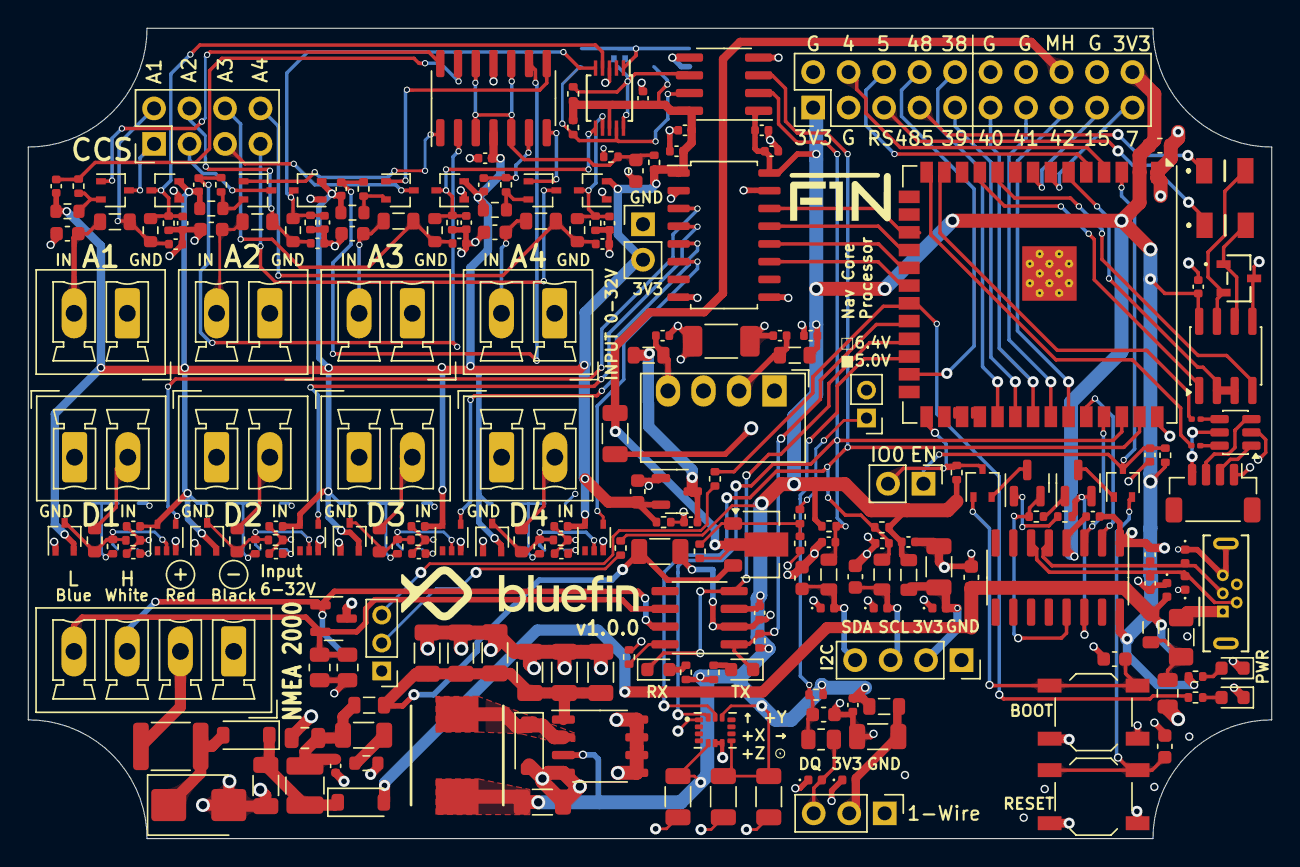
[picture p16: board HALMET.kicad_pcb from above]

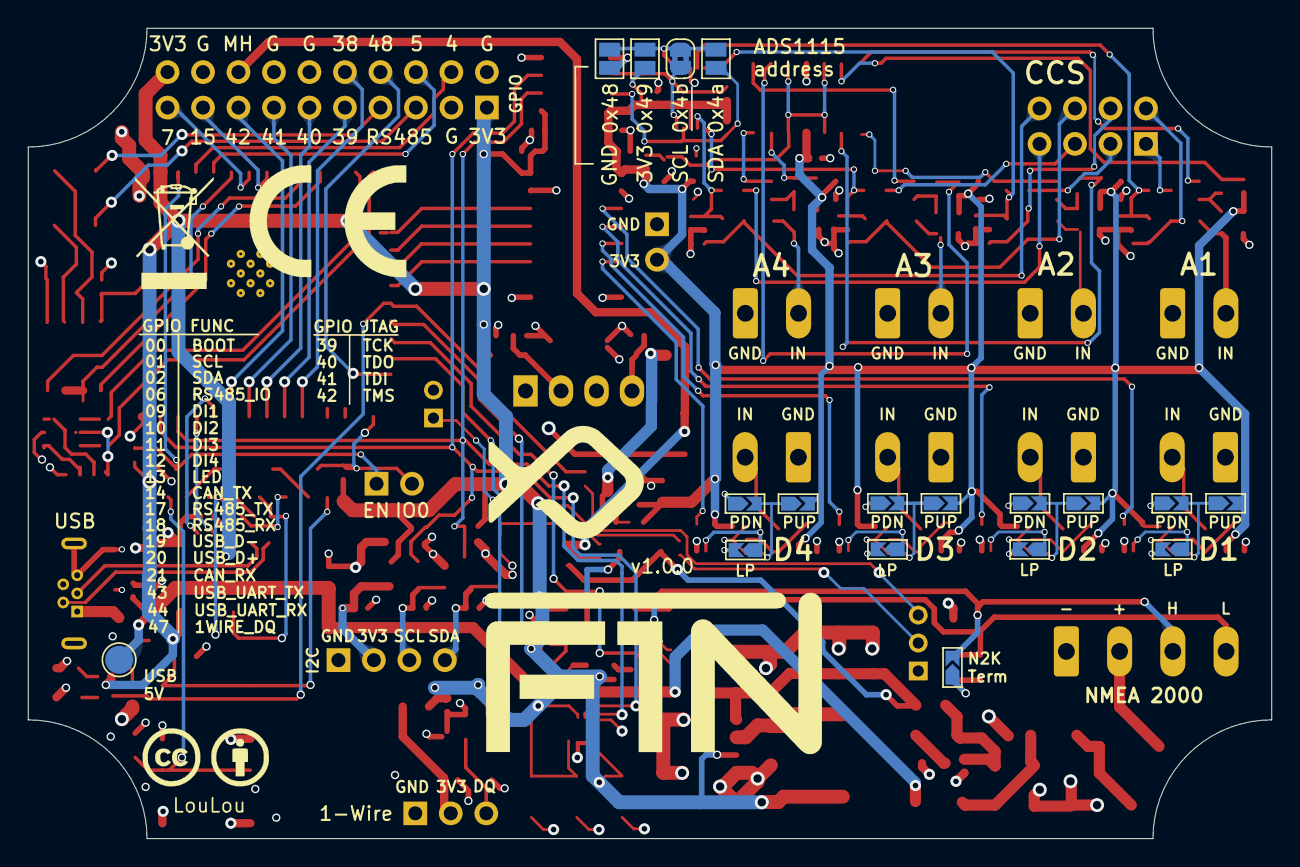
[picture p17: board HALMET.kicad_pcb from below]

Board: 4 copper layers, 89.0 x 58.0 mm, 243 parts (20 on the bottom side), 135 nets.
