stevehayles/HALMET-hardware/(commit log)

2025-12-01 Initial V1.0.0 Bluefin forked
    Added ICM-42688-P 6-axis IMU
    Added LM317 LDO for 6.4v or 5v MHU supply (selectable via jumper)
    Added External LED's for IO2 (Pin 24) and 3.3v
    [ESP32.kicad_sch, HALMET-B_Cu.dxf, HALMET-B_Mask.dxf, HALMET-B_Paste.dxf, HALMET-B_Silkscreen.dxf, HALMET-Edge_Cuts.dxf, HALMET-F_Cu.dxf, HALMET-F_Mask.dxf]
2025-12-01 Increases trace width on the front copper layer
    Increases trace width for better signal integrity or manufacturability on the front copper layer of the PCB.
    [HALMET.kicad_pcb]
2025-12-06 Added RS485/RS233 (NMEA 01830) chip
    Added SP3485EN RS485 bi-directional driver with a GPIO toggle for changing input - output direction.
    Connected to GPIO pin header
    [ESP32.kicad_sch, HALMET.kicad_pcb, HALMET.kicad_sch, canbus.kicad_sch, serial.kicad_sch]
2025-12-07 Changed to ESP32-S3-WROOM-1U
    Added ESP32-S3-WROOM-1U-N16R2 and updated all routing and pin assignments.
    Added USB-OTG connected via JST-PH
    [ESP32.kicad_sch, HALMET.kicad_pcb, HALMET.kicad_sch, USB.kicad_sch, serial.kicad_sch]
2025-12-07 Added TSV/ESD to the native USB
    [HALMET.kicad_pcb, USB.kicad_sch]
2025-12-07 Renames IO2 to IO13 for onboard LED
    The original label "IO2" was incorrect and has been updated to "IO13"
    to reflect the intended signal.
    [ESP32.kicad_sch]
2025-12-07 Silkscreen updates
    Back silkscreen bough up-to-date with GPIO pin changes
    [HALMET.kicad_pcb, HALMET.kicad_sch]
2025-12-08 Net renaming and Silkscreen tidy ups
    The UART / Serial naming convention is revised for more consistency
    [ESP32.kicad_sch, HALMET.kicad_pcb, HALMET.kicad_sch, USB.kicad_sch]
2025-12-08 Small track cleanup
    [HALMET.kicad_pcb]
2025-12-08 Added ESP32 Pin allocation summary sheet
    [ESP32-Pin-Allocation.xlsx]
2025-12-08 Adjust external LED resistor values for ~5 mA drive current
    Added series resistors for optional external panel LEDs on the GPIO13 (blue)
    and 3V3 (red) indicator lines. On-board LEDs retain their existing 2 kΩ
    resistors; external LEDs now use separate resistors sized for ~5 mA.
    Red LED:
    - Vf ≈ 2.1 V
    - Vr = 3.3 V – 2.1 V = 1.2 V
    - R = 1.2 V / 0.005 A = 240 Ω
    Blue LED:
    - Vf typically ≈ 3.0 V at a few mA (3.3 V worst case simply reduces brightness)
    - Vr = 3.3 V – 3.0 V = 0.3 V
    - R = 0.3 V / 0.005 A = 75 Ω
    Resulting currents fall in the 3–5 mA range depending on LED tolerance, with
    total GPIO13 load remaining well below ESP32-S3 limits. Red and blue LEDs now
    have comparable percei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
    [UI.kicad_sch]
2025-12-08 Changed MCU to ESP32-S3-WROOM-1U-N16R8
    ESP32-S3-WROOM-1U-N16R8 has 8 MB of Octal PSRAM
    [ESP32.kicad_sch]
2025-12-08 Updated LCSC part numbers
    [HALMET.kicad_pcb, I2C.kicad_sch, USB.kicad_sch, power-input.kicad_sch]
2025-12-18 Ignores KiCad lock files.
    Prevents accidental inclusion of KiCad lock files in the repository.
    These files are automatically created by KiCad when a schematic or PCB is open
    and should not be tracked by version control.
2025-12-18 Stop tracking KiCad lock files
2026-01-08 Moved ESP32-S3 + larger pin headers
    [ESP32.kicad_sch, HALMET.kicad_pcb, HALMET.kicad_sch, I2C.kicad_sch, PCB.kicad_sch, UI.kicad_sch, USB.kicad_sch, analog_input.kicad_sch]
2026-01-08 Updates LCSC part numbers.
    Updates LCSC part numbers in the schematics and PCB to reflect the correct components.
    This ensures accurate component sourcing and BOM generation.
    [Bluefin Parts Order.xlsx, HALMET.kicad_pcb, UI.kicad_sch, power-input.kicad_sch]
2026-01-08 Small text cleanups
    Some text too small, minimum now 0.8mm
    [HALMET.kicad_pcb]
2026-01-09 Repo tidy up
    [HALMET-B_Cu.gbr, HALMET-B_Mask.gbr, HALMET-B_Paste.gbr, HALMET-B_Silkscreen.gbr, HALMET-Edge_Cuts.gbr, HALMET-F_Cu.gbr, HALMET-F_Mask.gbr, HALMET-F_Paste.gbr]
