stevehayles/HALMET-hardware/(notices)

Notices in the files:
UI.kicad_sch:
https://creativecommons.org/licenses/by-sa/4.0
Bluefin is licensed under CC BY-SA 4.0
Modifications © 2026 Fiftyone North Ltd.
